oolah10293/Big-Dirty/design/README.md

# Design Artifacts

Files in this directory are concrete design contracts and examples. They are **not** part of the active Arduino sketch and are not compiled with Big Dirty.

Current design:

- [HC58_Transport_API.h](HC58_Transport_API.h) — proposed public interface for the shared MC68HC58 transport

Architecture and migration details:

- [../docs/HC58_SHARED_TRANSPORT_DESIGN.md](../docs/HC58_SHARED_TRANSPORT_DESIGN.md)

The authoritative hardware evidence is under:

- [../tests/HC58_INT_Diagnostic/RESULTS_2026-10-23.md](../tests/HC58_INT_Diagnostic/RESULTS_2026-10-23.md)
