oolah10293/Big-Dirty/tests/HC58_INT_Diagnostic/results/README.md

# Raw HC58 INT Diagnostic Logs

These are the original Tera Term text logs compressed with deterministic gzip (`gzip -n`).

To inspect on Linux/macOS:

```bash
gzip -dc 2026-10-23_full_20x3.txt.gz | less
gzip -dc 2026-10-23_irq_only_100.txt.gz | less
```

On Windows, 7-Zip can extract the `.txt` files.

## Files

### `2026-10-23_full_20x3.txt.gz`

Contains the complete automatic comparison:

- 20 MASKED_POLL requests
- 20 IRQ_POLL requests
- 20 IRQ_ONLY requests

Original text:

- bytes: 36,366
- lines: 290
- SHA-256: `53e5263e002020cf282a9796cfd1e88b192a1440c4772018ea10dfd541734b48`

Compressed file:

- SHA-256: `8226fb94a6903bd199143d66f5035d2422acbb4da645e277cdcb5f9499b5d9f4`

### `2026-10-23_irq_only_100.txt.gz`

Contains the complete automatic comparison followed by the separate 100-request IRQ-only run.

Original text:

- bytes: 94,458
- lines: 722
- SHA-256: `775fb031502ac266ff954c5989b3a8504713ebd2eb29bccb24e834bc68477c17`

Compressed file:

- SHA-256: `5d501b6d61a9bf321157b82bfb63f9031c0f13a74aec4cfa5955843be496bf9d`

### `live_test_2_2026-10-24.txt.gz`

Live Test 2 full-warm-up/page-cycling/ignition-off USB diagnostic capture for commit:

    8f6c261699c483f7b82a2824a6d3aca33fe8bd89

Result:

- 16,545 completed frames
- RFO 0
- ERR 0
- TRUNC 0
- BUDGET 0
- STUCK 0
- CONFLICT 0

Original text:

- bytes: 7,219
- diagnostic lines: 81
- SHA-256: `7462e6aea04800b2691f5815b9302ea9db0efdea8fe6bd57525b2e17e2795c80`

Compressed file:

- SHA-256: `e23c1d269915ee522c64332cbb605b2ba4928c23c57a9ccb5c86b8fbd375fca7`

Full interpretation:

- `docs/HC58_DISPLAY_SERVICE_TEST_RESULTS_2026-10-24.md`
