oolah10293/Big-Dirty/history/README.md

# Historical Checkpoints

This directory preserves source provenance and earlier project states.

## FINAL_SAVE_14_MANIFEST.md

The definitive provenance record for `BigDirty_UI_Main - Save 14.zip`, supplied on 2026-09-16 and identified as the final version.

It records:

- archive size and SHA-256
- all 31 source files
- per-file byte sizes
- SHA-256 hashes
- Git blob hashes
- the four files that differed from the previous GitHub state

The repository root now matches this Save 14 source snapshot.

## FULL_PROJECT_CODE_2026-03-14.txt

Recovered from the saved project-file library.

It is a combined text export containing many source files as they existed on 2026-03-14.

It predates both the April integrated build and final Save 14. In particular, the older snapshot contains earlier/placeholder PID and DTC stages.

Use it to recover an old implementation detail, understand when behavior changed, compare page/display evolution, or preserve source that might otherwise disappear.

Do not overwrite current source with it wholesale.

## 2026-04-07 Git checkpoint

The original repository upload remains available in Git history. It was a highly complete integrated build but is superseded by Save 14.

Only four source files changed between that checkpoint and Save 14.

## Root historical sketch

`Four_PIDs_at_once.ino` remains in the repository root because it is a small, important HC58 timing reference and was already part of the original repository snapshot.
