oolah10293/Big-Dirty/history/FINAL_SAVE_14_MANIFEST.md

# Big Dirty Final Save 14 Manifest

## Authority

Archive supplied: `BigDirty_UI_Main - Save 14.zip`

Identified by the project owner as: **final version**

Recovered: **2026-09-16**

Archive size: **36,459 bytes**

Archive SHA-256:

    796d88659c82b9c2126da6ee5c1ea51ffc89b3903e8b878baae54b5e1e9f73a0

The archive contains one directory plus **31 source files**.

## Comparison with previous GitHub source

Against the prior repository source checkpoint:

- 27 of 31 source files matched byte-for-byte
- 4 files differed and were restored from Save 14

| File | Save 14 Git blob SHA |
|---|---|
| `DTC_Manager.cpp` | `e4be6beab7b01d5747f25e9a8447dca3bff45d2e` |
| `Display_ST7796S.cpp` | `20c73b092f2fda67f15a9c223a9929cb43826bad` |
| `Page_DTC.cpp` | `d847a40a6da0fb5f1d6870654fe5f7f3b44da230` |
| `Page_Env.cpp` | `a5e47502a933484367944a4f5b930358db3b2a80` |

The final root source was committed only after these four repository blobs matched the archive's computed Git blob hashes exactly.

## Complete file manifest

| File | Bytes | SHA-256 | Git blob SHA |
|---|---:|---|---|
| `BigDirty_UI_Main.ino` | 1161 | `2cb2c7095e2c99ff70e863632905192cdda05f98e663aef75e9b87c5b8da06bf` | `26f7e839bd38b98967547f57d2cfce53dabd3f6d` |
| `Display_Fonts.cpp` | 14704 | `38687eefdf48cb3f81ad7b0cc482d0ffadc1442e2802639f815ded1ed6534031` | `774d064a65e1d759107bb5d82a249879373b78ed` |
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
- generalized positive/negative reply handling
- post-clear combined reread

### Display_ST7796S.cpp

Save 14 removes nested display transaction ownership:

- `displaySPI_begin()`
- `displaySPI_end()`
- `setAddrWindow()` assumes caller owns SPI
- touch CS is held high during display transactions

### Page_DTC.cpp

Final user-facing state wording:

- SCANNING CODES
- NO DIAGNOSTIC CODES
- CODE READ ERROR
- CODE REQUEST ERROR

### Page_Env.cpp

Final robustness changes include:

- transmission-temperature interval 1500 ms
- DHT three-failure give-up state
- I2C timeout
- stale-value fallback to `---`
- current-reference validity checks
- transmission-temperature validity checks
- fresh sensor state on each ENV page entry
