oolah10293/Big-Dirty/Interface board schematic.pdf

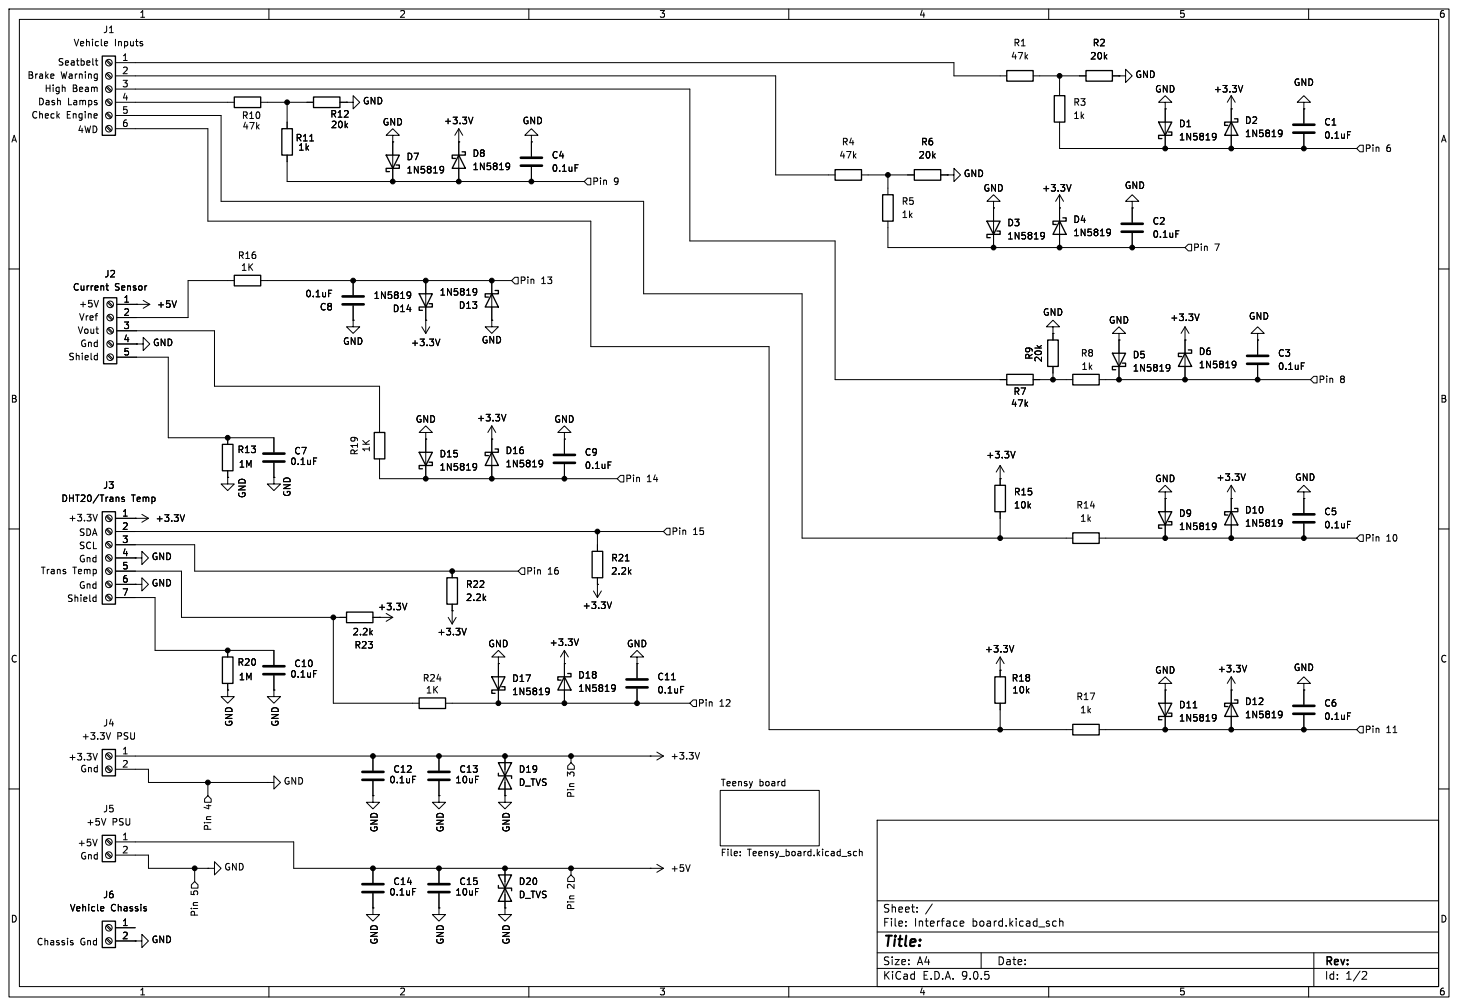
[picture p2: page 1]

Seatbelt Gnd +3.3V
Vref Gnd Dash Lamps Brake Warning
High Beam

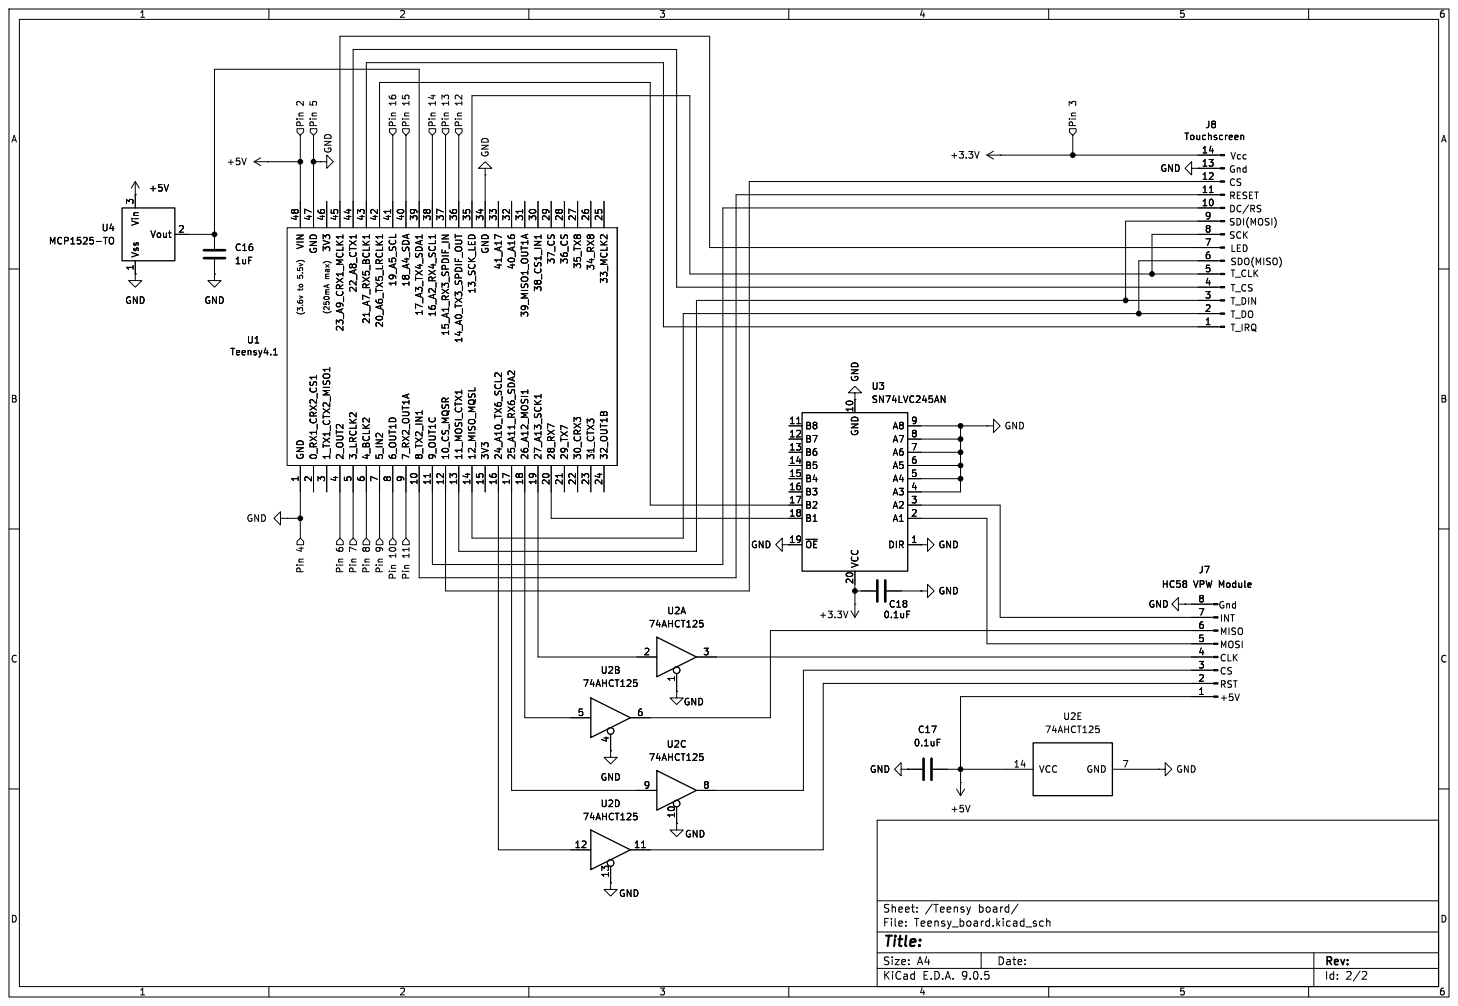
[picture p3: page 2]

SDI(MOSI) RESET GND GND
