oolah10293/Big-Dirty/Page_Env.h

#pragma once

void Page_Env_begin();
void Page_Env_update();

void Page_Env_setQ1Value(const char *value);
void Page_Env_setQ2Value(const char *value);
void Page_Env_setQ3Value(const char *value);
void Page_Env_setQ4Value(const char *value);
