oolah10293/Big-Dirty/PinConfig.cpp

#include "PinConfig.h"

// Display pins
const int TFT_CS  = 10;
const int TFT_DC  = 9;
const int TFT_RST = 8;
const int TFT_LED = 23;

// Touch pins
const int T_CS  = 22;
const int T_IRQ = 21;

// Screen backlight
const int DIMMER_SENSE = 20;

// Warnings
const int PIN_SEATBELT     = 2;
const int PIN_BRAKE        = 3;
const int PIN_HIGHBEAM     = 4;
const int PIN_CHECK_ENGINE = 6;
const int PIN_4WD          = 7;
