oolah10293/Big-Dirty/PinConfig.h

#pragma once

// Shared Teensy pin assignments

extern const int TFT_CS;
extern const int TFT_DC;
extern const int TFT_RST;
extern const int TFT_LED;

extern const int T_CS;
extern const int T_IRQ;

extern const int DIMMER_SENSE;

extern const int PIN_SEATBELT;
extern const int PIN_BRAKE;
extern const int PIN_HIGHBEAM;
extern const int PIN_CHECK_ENGINE;
extern const int PIN_4WD;
