oolah10293/Big-Dirty/(commit log)

2026-10-20 Add HC58 RFS and interrupt-driven capture logic
2026-10-20 Harden Arduino prototype ordering in HC58 diagnostic
2026-10-20 Avoid Arduino default-argument prototype ambiguity
    [B_Capture.ino]
2026-10-20 Move shared diagnostic type ahead of Arduino prototypes
2026-10-23 Record validated HC58 interrupt test evidence
2026-10-23 Design shared interrupt-driven HC58 transport
2026-10-24 Implement shared interrupt-driven HC58 transport
2026-10-24 Correct live-test DTC manager source
    [DTC_Manager.cpp]
